uutzinger/esk8/Readme.md

# Building Electric Skateboard

## [Wires and Connectors](Wire_Connectors.md)

## [Skateboard Design](ElectricSkateBoard.md)

## [Current limitting anti spark switch](Switch.md)

## [ODrive Setup](ODrive_v3.md)
