uutzinger/esk8/SparkSwitch/README.md

# SparkSwitch
https://github.com/vedderb/SparkSwitch

Have a look at this thread:
https://endless-sphere.com/forums/viewtopic.php?f=3&t=40142&start=100
