uutzinger/esk8/Switch.md

# Antispark On/Off Switch, 200+ Amp

## References

* ‎Find the parts: https://octopart.com
* The switch: https://github.com/vedderb/SparkSwitch
* The simulation of the switch: https://www.multisim.com/content/NLP7B94HVyqndpwCyjrKdE/vedder-anti-spark-switch
* https://github.com/msglazer/Anti-Spark_Switch
* https://endless-sphere.com/forums/viewtopic.php?f=3&t=40142&start=100
* https://www.youtube.com/watch?v=UdzIOw9pgfw

## FET 60V - 240A
Power MOSFET N Channel
IRFS7530, 
VDSS 60V, ID 240A, Power Dissipation 375W, 
RDSON 1.15mOhm @10V, 
VGS thresh 2.1-3.7 thresh, +/20V, 10V 
Out of stock

## FET 75V - 240A
Power MOSFET N Channel, 
IRFS7730,  
D2PAK-7 same as TO-263-7, 
VDSS 75V, 240A, 375W
RDSON 1.7mOhm @ 10V Vg, 
V GS: thresh 3.7V thresh, +/-20V, 10V 
‎IRFS7730TRL7PPCT-ND‎, 
Digikey: $3.67

## Zener Diode
12V, 0.5W, 
SOD-123F, 
Izt 5mA, 
25Ohm at Izt, 
90nA reverse at 8V, 
1V forward, 
‎BZT52C12RHGCT-ND‎, 
digkey 0.20

## Ceramic Capcitor 
100V,  
1microF, 
0805, 
TDK,  
C2012X7S2A105M125AB, 
Digikey 0.5

## Resistors
### 1M
0603, 
100mW, 
75V, 
Panasonic, 
‎10-ERJ-U03J105VCT-ND‎, 
digikey 0.1

### 1k	
0603, 
100mW, 
10-ERJ-U03J102VCT-ND‎, 
Panasonic,
digikey, 
$0.1

## Fuse
200A, 58V,  
Slow Blow, 
‎142.5631.6202‎, 
Littel Fuse, 
Digikey, 
$4.0

## Mounting Screws
M5x0.8 Torx 10mm

## M5 Copper Washer
98044A220, 
MacMaster Carr, 
Pack of 10 8.44
