uutzinger/esk8/Deligreen.jpg

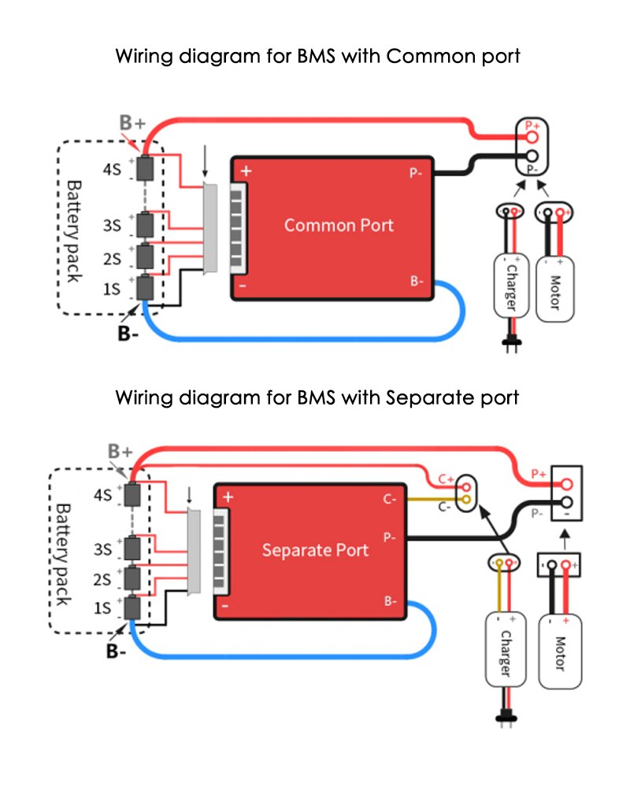
Deligreen.jpg
