uutzinger/esk8/SparkSwitch/SparkSwitch_BOM.ods

Reference | Value | Case (In) | Part number | Quantity | Mouser Part Number | Mfg Name | Description
R1 | 1M | 0603 | ERJ-3EKF1004V | 1 | 667-ERJ-3EKF1004V | Panasonic
R2 | 1k | 0603 | 3EKF1001V | 1 | 667-ERJ-3EKF1001V | Panasonic
C1 | 1u/100V | 0805 | GRJ21BC72A105KE1L | 1 | 81-GRJ21BC72A105KE1L | Murata Electronics
D2 | Zener 12V | SOD-123 | BZT52B12 | 1 | 821-BZT52B12 | Taiwan Semiconductor
Q1,Q2 | MOSFET 60V | D2PAK-7 | IRFS7530TRL7PP | 2 | 942-IRFS7530TRL7PP | International Rectifier
