uutzinger/esk8/Deck.dxf

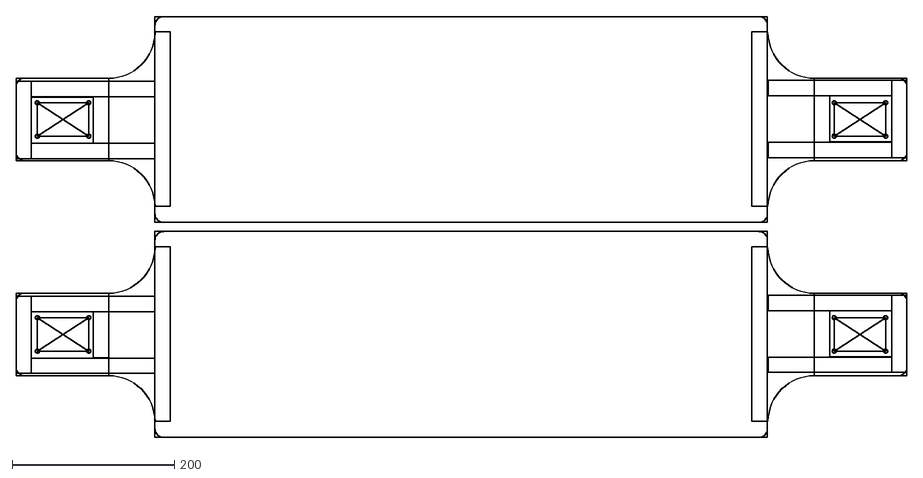
[picture p8: CAD file, 2021-07-09]
Deck.dxf
1098.8 x 519.3
