uutzinger/esk8/DeckParts/DeckTop.dxf

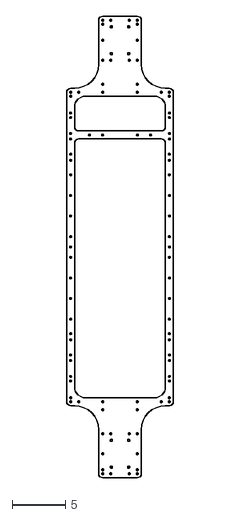
[picture p9: CAD file, 2021-07-09]
DeckParts/DeckTop.dxf
10.0 x 43.3
