uutzinger/esk8/MotorPlate/Motor Plate V2.dxf

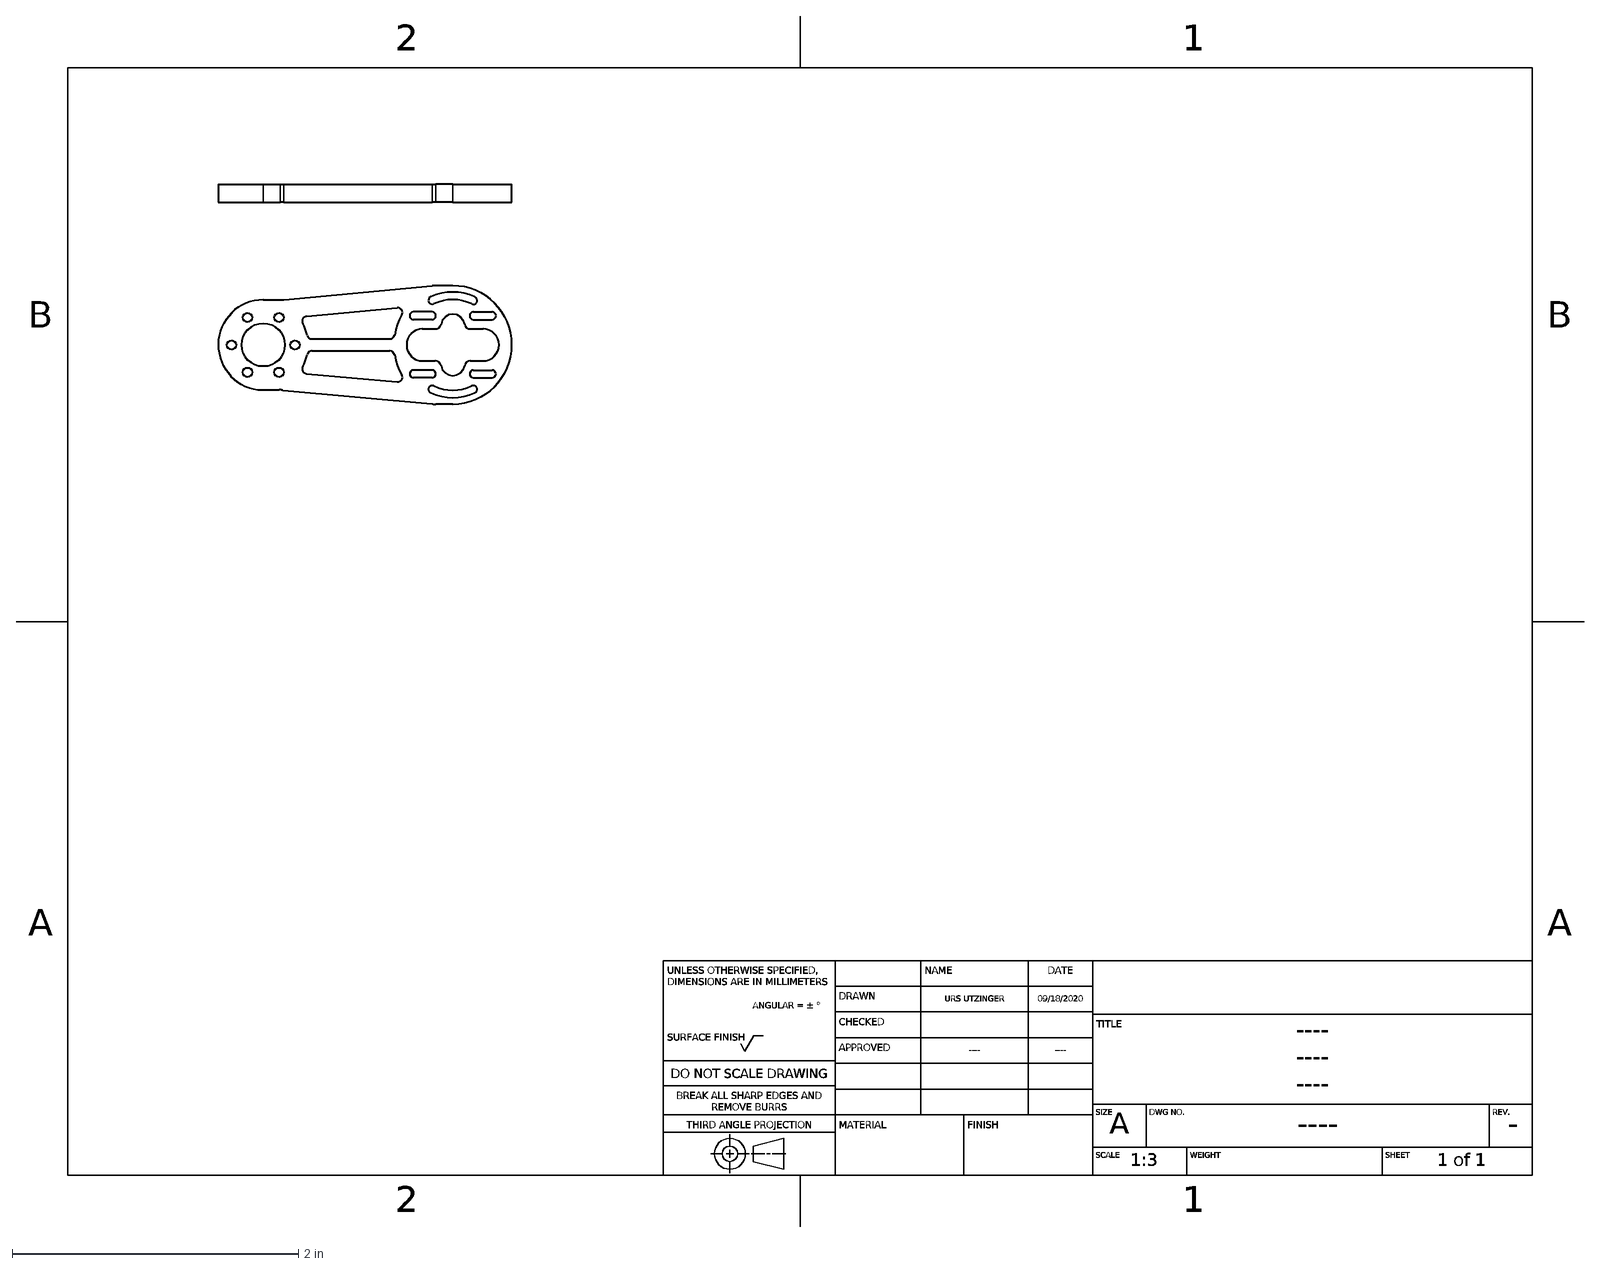
[picture p10: CAD file, 2020-11-23]
MotorPlate/Motor Plate V2.dxf
2
1
A
B
UNLESS OTHERWISE SPECIFIED, DIMENSIONS ARE IN MILLIMETERS
ANGULAR = ± °
SURFACE FINISH
DO NOT SCALE DRAWING
BREAK ALL SHARP EDGES AND REMOVE BURRS
THIRD ANGLE PROJECTION
NAME
DATE
DRAWN
URS UTZINGER
09/18/2020
CHECKED
APPROVED
----
MATERIAL
FINISH
TITLE
SIZE
DWG NO.
REV.
-
SCALE
1:3
WEIGHT
SHEET
1 of 1
