uutzinger/esk8/DeckParts/DeckBottom.dxf

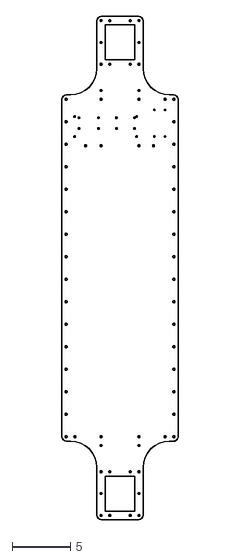
[picture p11: CAD file, 2021-07-09]
DeckParts/DeckBottom.dxf
10.0 x 43.3
