uutzinger/esk8/MotorPlate/Motor Plate V2_OMAX.dxf

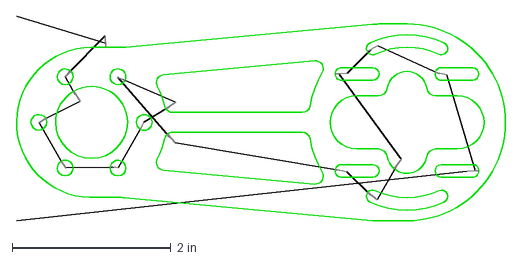
[picture p12: CAD file, 2020-11-23]
MotorPlate/Motor Plate V2_OMAX.dxf
6.22 x 2.58 in
