uutzinger/esk8/ODrive.step

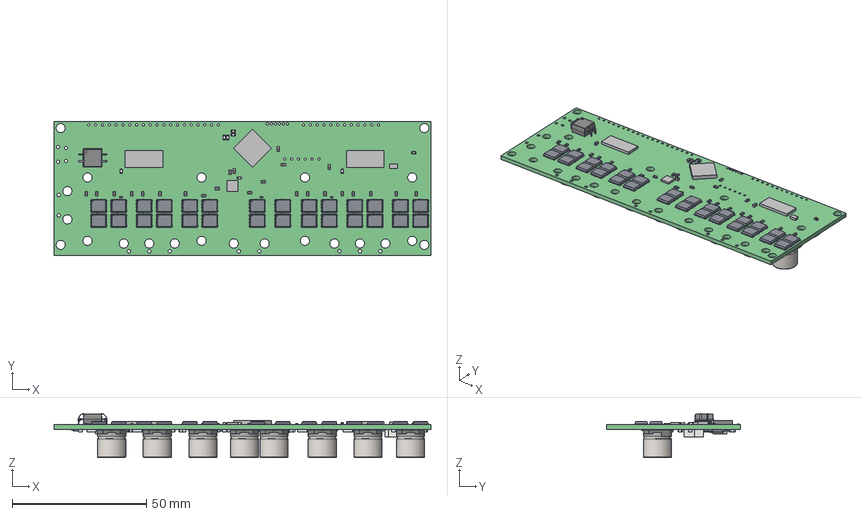
[picture p13: CAD file, 2021-07-09]
ODrive.step
140.5 x 50.0 x 16.4 mm
Board
RES_0603_(1608_metric) x 53
Extruded x 206
Open_CASCADE_STEP_translator_6.8_2.1
Open_CASCADE_STEP_translator_6.8_2.2.1
Leader x 4
SOT23-5
RES_0402_(1005_metric) x 3
SOT223-4
User_Library-DFN5x6_SO8FL_Extruded x 56
User_Library-DFN5x6_SO8FL_Extruded_2 x 56
User_Library-DFN5x6_SO8FL_Cylinder x 28
User_Library-DFN5x6_SO8FL_Extruded_3 x 28
User_Library-DFN5x6_SO8FL_Extruded_4 x 28
User_Library-DFN5x6_SO8FL_Extruded_5 x 112
User_Library-DFN5x6_SO8FL_Extruded_6 x 28
CAP_Alum_Elec_Size_G x 8
LED_0603_APT1608_GREEN
