uutzinger/esk8/Battery Cable Route.3mf

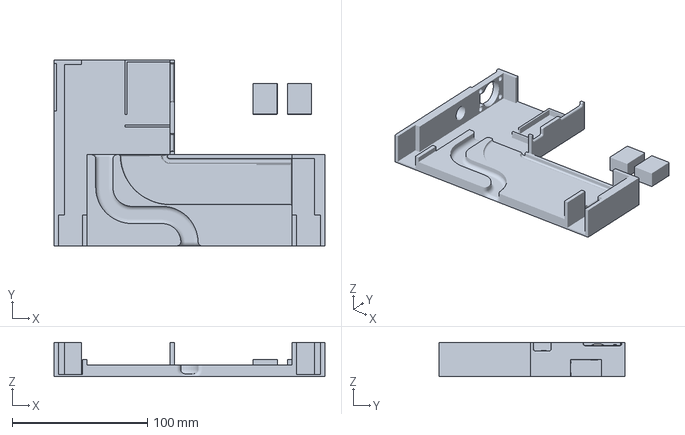
[picture p14: CAD file, 2020-11-23]
Battery Cable Route.3mf
200.0 x 137.2 x 25.4 mm
