uutzinger/esk8/DeckParts/TransparentTop.dxf

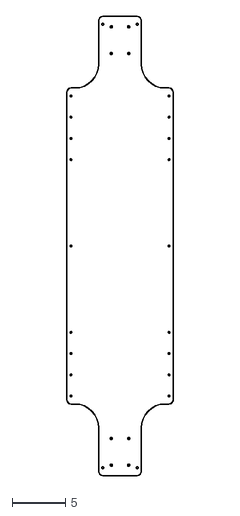
[picture p15: CAD file, 2021-07-09]
DeckParts/TransparentTop.dxf
10.0 x 43.3
