uutzinger/esk8/MotorPlate/Motor Plate.dxf

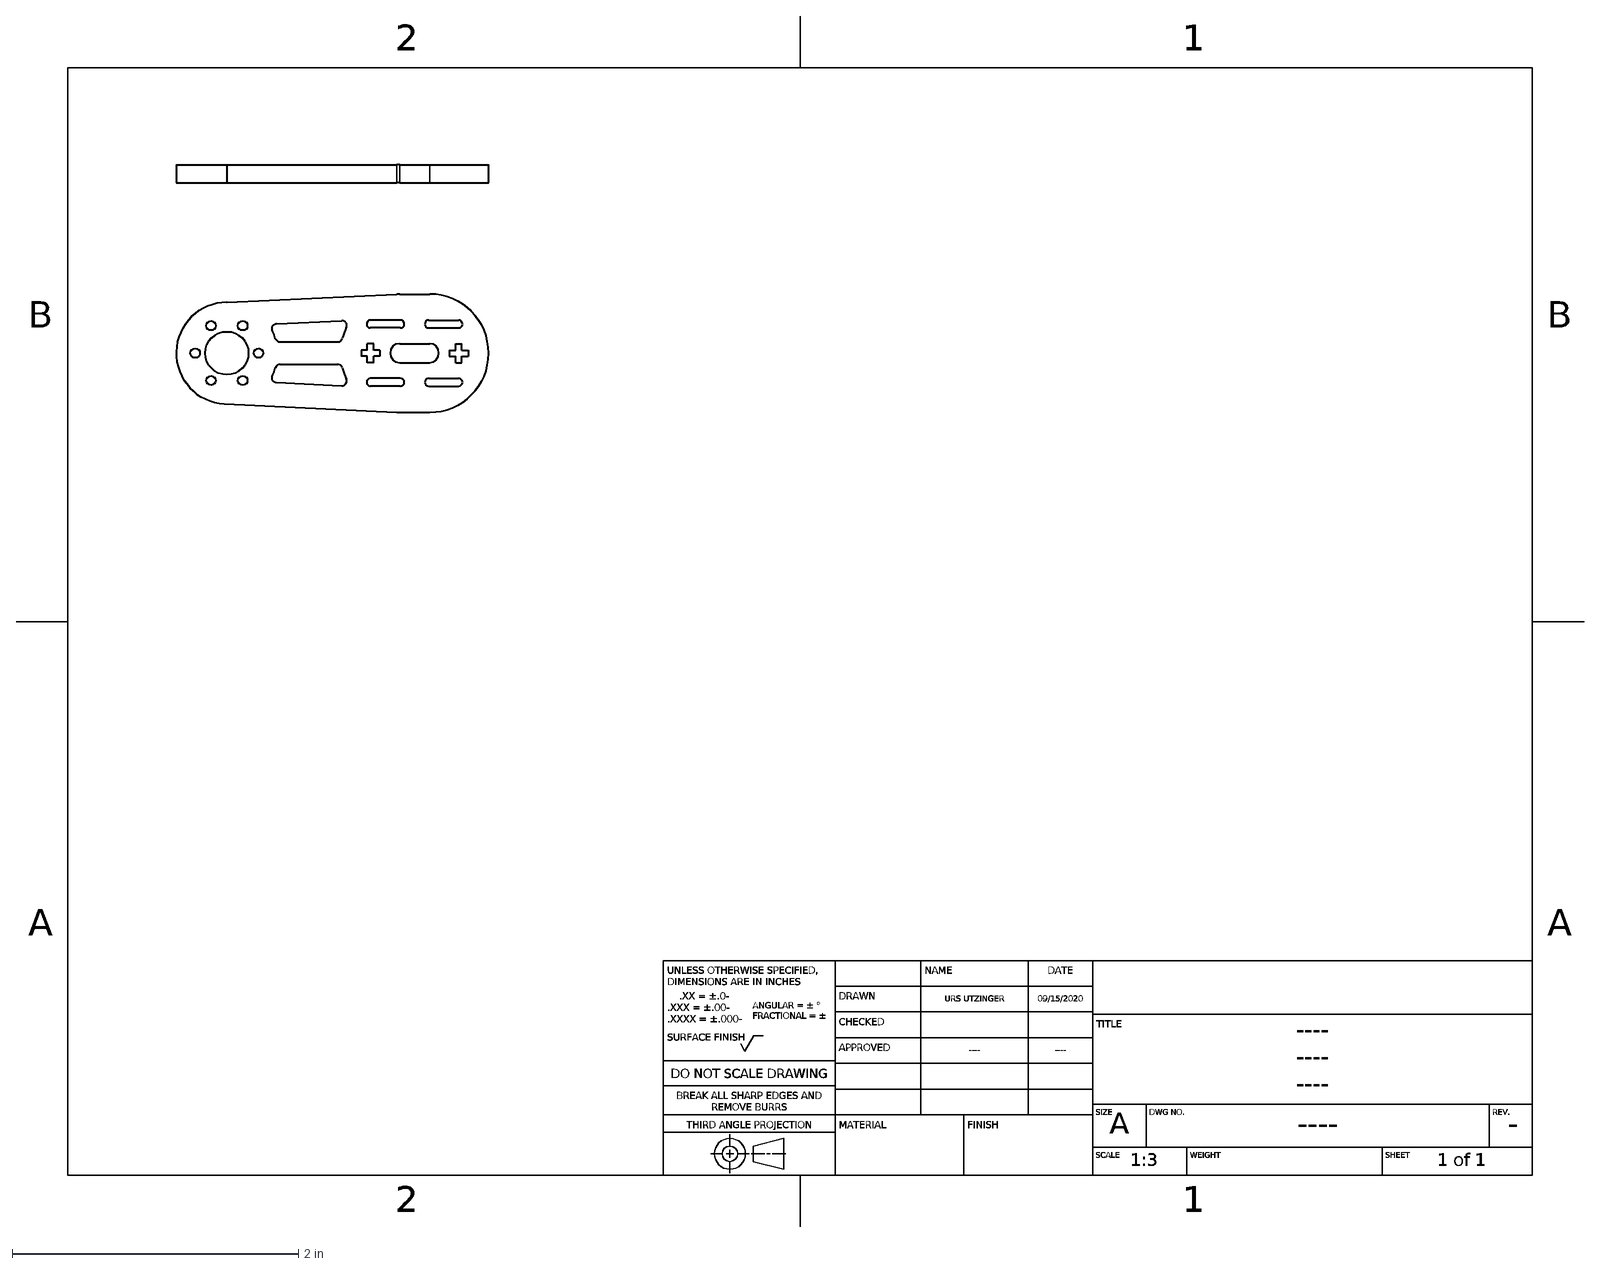
[picture p16: CAD file, 2020-11-23]
MotorPlate/Motor Plate.dxf
2
1
A
B
UNLESS OTHERWISE SPECIFIED, DIMENSIONS ARE IN INCHES
.XX = ±.0- .XXX = ±.00- .XXXX = ±.000-
ANGULAR = ± ° FRACTIONAL = ±
SURFACE FINISH
DO NOT SCALE DRAWING
BREAK ALL SHARP EDGES AND REMOVE BURRS
THIRD ANGLE PROJECTION
NAME
DATE
DRAWN
URS UTZINGER
09/15/2020
CHECKED
APPROVED
----
MATERIAL
FINISH
TITLE
SIZE
DWG NO.
REV.
-
SCALE
1:3
WEIGHT
SHEET
1 of 1
