uutzinger/esk8/MotorPlate/Motor Plate_OMAX.dxf

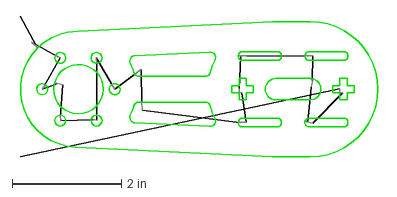
[picture p17: CAD file, 2020-11-23]
MotorPlate/Motor Plate_OMAX.dxf
6.69 x 2.58 in
