uutzinger/esk8/(list of files, cad)

Other CAD files:
Battery Cable Route.stl
