uutzinger/esk8/SparkSwitch/SparkSwitch.brd

## EAGLE design SparkSwitch/SparkSwitch.brd (2023-09-17)

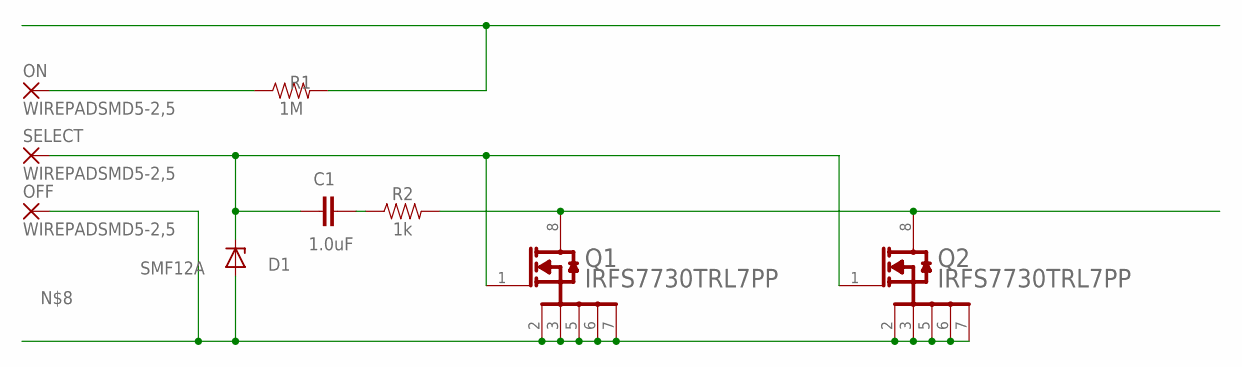
[picture p18: schematic SparkSwitch.sch]

Parts:
C1: 1.0uF; 0805
D1: SMF12A; SOD123F
OFF: WIREPADSMD5-2,5; 5-2,5
ON: WIREPADSMD5-2,5; 5-2,5
Q1, Q2: INFINEON_IRFS7730TRL7PPINFINEON_IRFS7730TRL7PP_0_0; INFINEON_IRFS7730TRL7PP_0
R1: 1M; 0603
R2: 1k; 0603
SELECT: WIREPADSMD5-2,5; 5-2,5

Connections:
unnamed: Q1.8 (D), Q2.8 (D), R2.2
unnamed: C1.1, D1.C, Q1.1 (G), Q2.1 (G), SELECT.1
unnamed: C1.2, R2.1
unnamed: ON.1, R1.1
unnamed: D1.A, OFF.1, Q1.2 (1_S), Q1.3 (2_S), Q1.5 (3_S), Q1.6 (4_S), Q1.7 (5_S), Q2.2 (1_S), Q2.3 (2_S), Q2.5 (3_S), Q2.6 (4_S), Q2.7 (5_S)

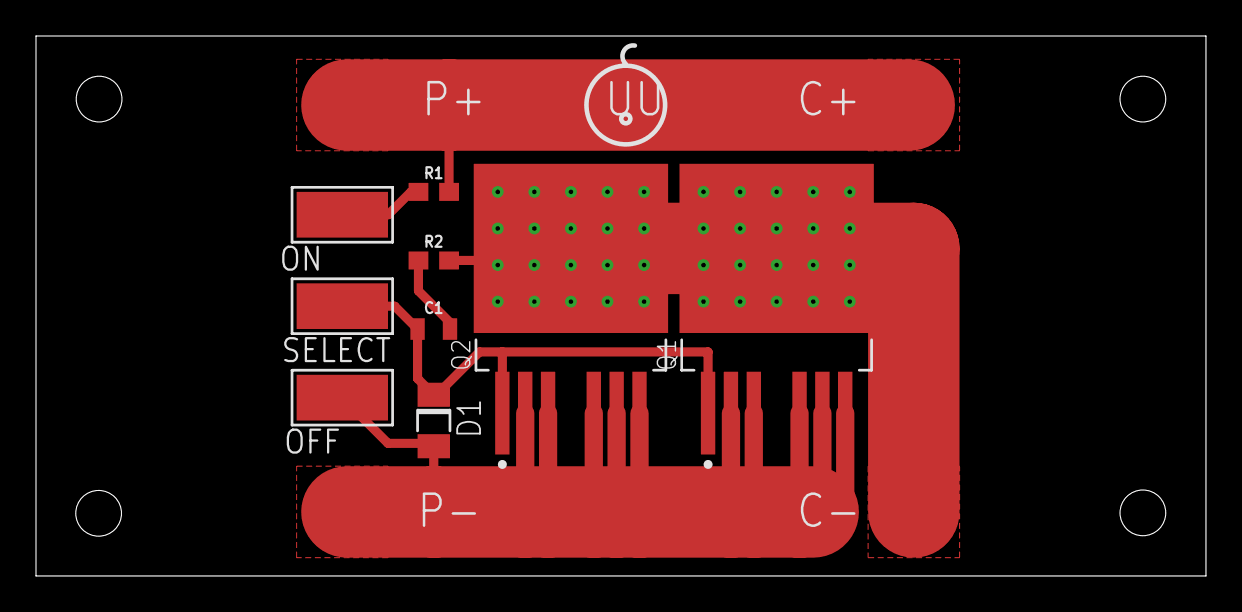
[picture p19: board SparkSwitch.brd from above]

Board: 2 copper layers, 65.0 x 30.0 mm, 9 parts (0 on the bottom side), 5 nets.
