uutzinger/esk8/(commit log)

2020-11-23 Some progress
    [Battery Cable Route.3mf, Battery Cable Route.stl, Motor Plate V2.dxf, Motor Plate V2_OMAX.dxf, Motor Plate.dxf, Motor Plate_OMAX.dxf]
2021-07-09 Deck Design
    [Deck.dxf, DeckBottom.dxf, DeckTop.dxf, Motor Plate V2.dxf, Motor Plate V2_OMAX.dxf, Motor Plate.dxf, Motor Plate_OMAX.dxf, ODrive.step]
2021-12-22 Motor sensor wires
2023-09-05 ODrive Connections
2023-09-11 Odrive Tuning
2023-09-20 Odrive Optimizations
2023-10-03 Rename ODrive v3.md to ODrive_v3.md
2023-10-16 Update ODrive v3.md
